gergelytothh/metromap/docs/images/pcb-3d.png

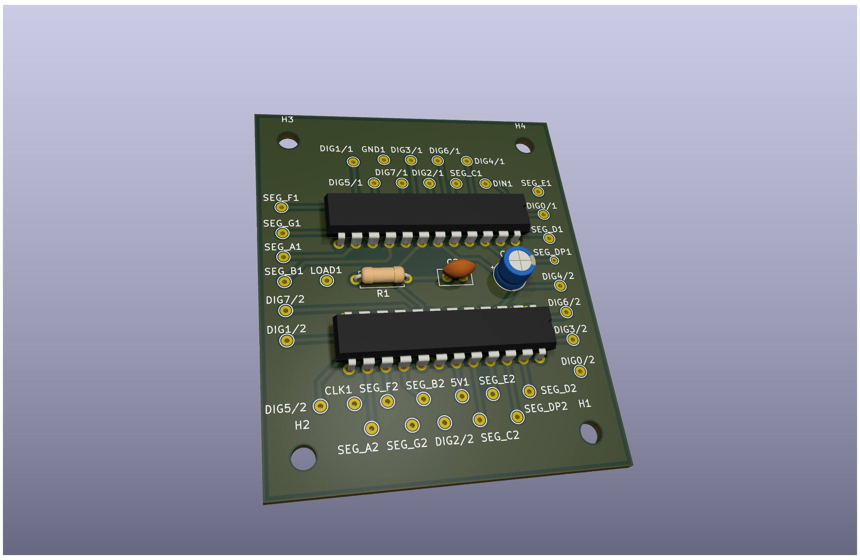
docs/images/pcb-3d.png
