gergelytothh/metromap/hardware/Metromap schematic.pdf

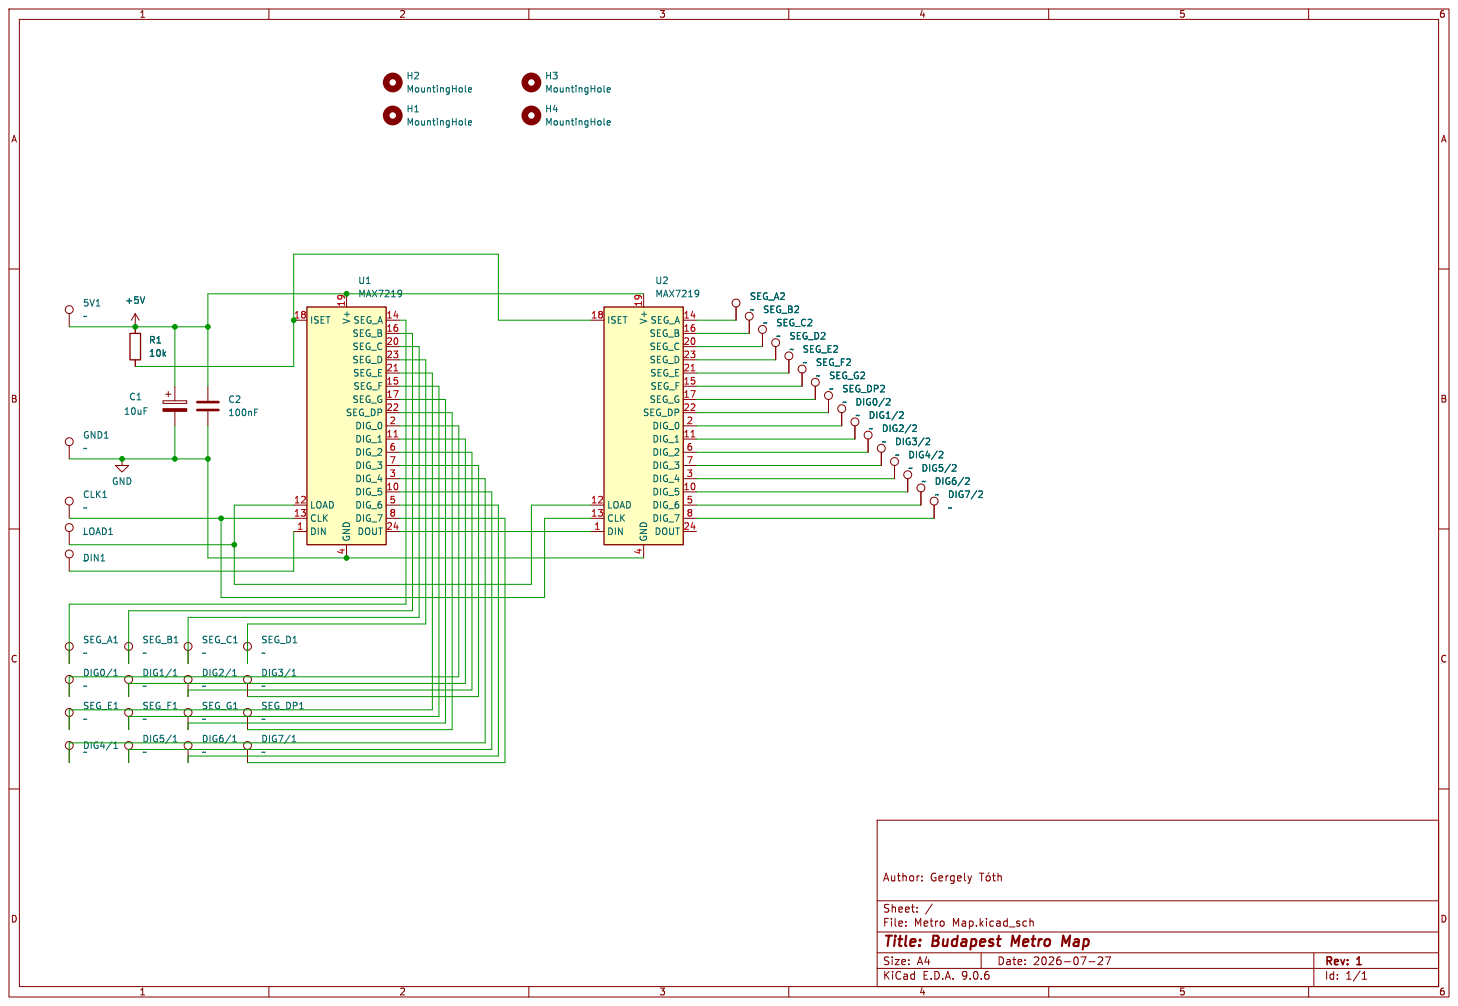
[picture p6: page 1]

Id: 1/1 Title: Budapest Metro Map
