gergelytothh/metromap/hardware/kicad/Metro Map.kicad_pcb

## KiCad design hardware/kicad/Metro Map.kicad_pcb (2026-10-12)

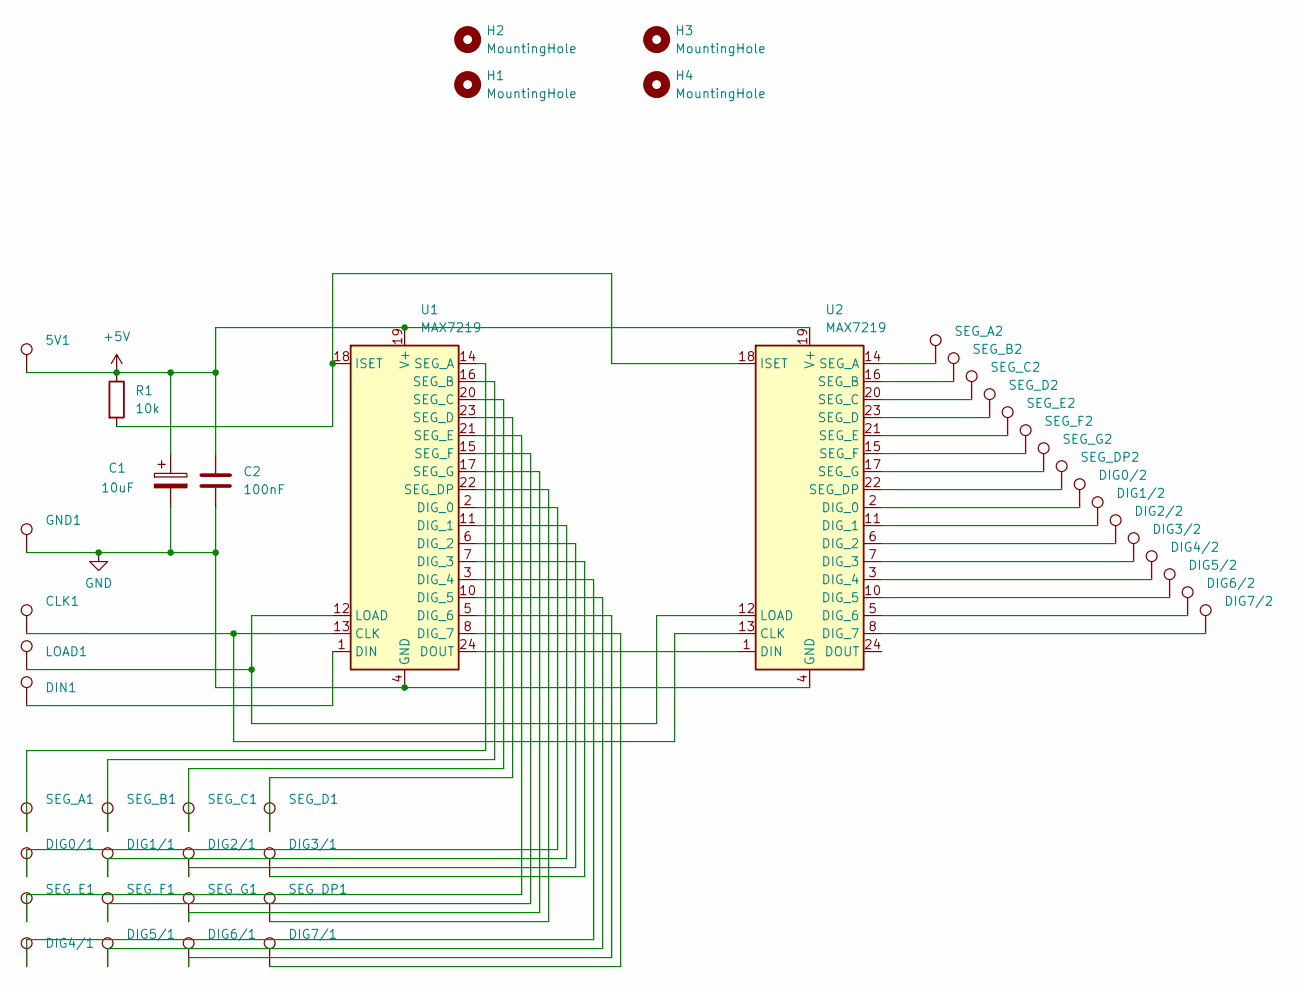
[picture p7: schematic Metro Map.kicad_sch, Budapest Metro Map]

Parts:
5V1: TestPoint_THTPad_D1.5mm_Drill0.7mm
C1: 10uF; CP_Radial_D5.0mm_P2.00mm
C2: 100nF; C_Disc_D5.0mm_W2.5mm_P2.50mm
CLK1: TestPoint_THTPad_D1.5mm_Drill0.7mm
DIG0/1, DIG0/2, DIG1/1, DIG1/2, DIG2/1, DIG2/2, DIG3/1, DIG3/2, DIG4/1, DIG4/2, DIG5/1, DIG5/2, DIG6/1, DIG6/2, DIG7/1, DIG7/2: TestPoint_THTPad_D1.5mm_Drill0.7mm
DIN1: TestPoint_THTPad_D1.5mm_Drill0.7mm
GND1: TestPoint_THTPad_D1.5mm_Drill0.7mm
H1, H2, H3, H4: MountingHole; MountingHole_3.2mm_M3
LOAD1: TestPoint_THTPad_D1.5mm_Drill0.7mm
R1: 10k; R_Axial_DIN0207_L6.3mm_D2.5mm_P7.62mm_Horizontal
SEG_A1, SEG_A2: TestPoint_THTPad_D1.5mm_Drill0.7mm
SEG_B1, SEG_B2: TestPoint_THTPad_D1.5mm_Drill0.7mm
SEG_C1, SEG_C2: TestPoint_THTPad_D1.5mm_Drill0.7mm
SEG_D1, SEG_D2: TestPoint_THTPad_D1.5mm_Drill0.7mm
SEG_DP1, SEG_DP2: TestPoint_THTPad_D1.5mm_Drill0.7mm
SEG_E1, SEG_E2: TestPoint_THTPad_D1.5mm_Drill0.7mm
SEG_F1, SEG_F2: TestPoint_THTPad_D1.5mm_Drill0.7mm
SEG_G1, SEG_G2: TestPoint_THTPad_D1.5mm_Drill0.7mm
U1, U2: MAX7219; DIP-24_W7.62mm

Connections:
+5V: 5V1.1, C1.1, C2.1, R1.1, U1.19 (V+), U2.19 (V+)
GND: C1.2, C2.2, GND1.1, U1.4 (GND), U1.9 (GND), U2.4 (GND), U2.9 (GND)
unnamed: CLK1.1, U1.13 (CLK), U2.13 (CLK)
unnamed: DIG0/1.1, U1.2 (DIG_0)
unnamed: DIG1/1.1, U1.11 (DIG_1)
unnamed: DIG2/1.1, U1.6 (DIG_2)
unnamed: DIG3/1.1, U1.7 (DIG_3)
unnamed: DIG4/1.1, U1.3 (DIG_4)
unnamed: DIG5/1.1, U1.10 (DIG_5)
unnamed: DIG6/1.1, U1.5 (DIG_6)
unnamed: DIG7/1.1, U1.8 (DIG_7)
unnamed: DIN1.1, U1.1 (DIN)
unnamed: U1.24 (DOUT), U2.1 (DIN)
unnamed: R1.2, U1.18 (ISET), U2.18 (ISET)
unnamed: LOAD1.1, U1.12 (LOAD), U2.12 (LOAD)
unnamed: SEG_A1.1, U1.14 (SEG_A)
unnamed: SEG_B1.1, U1.16 (SEG_B)
unnamed: SEG_C1.1, U1.20 (SEG_C)
unnamed: SEG_D1.1, U1.23 (SEG_D)
unnamed: SEG_DP1.1, U1.22 (SEG_DP)
unnamed: SEG_E1.1, U1.21 (SEG_E)
unnamed: SEG_F1.1, U1.15 (SEG_F)
unnamed: SEG_G1.1, U1.17 (SEG_G)
unnamed: DIG0/2.1, U2.2 (DIG_0)
unnamed: DIG1/2.1, U2.11 (DIG_1)
unnamed: DIG2/2.1, U2.6 (DIG_2)
unnamed: DIG3/2.1, U2.7 (DIG_3)
unnamed: DIG4/2.1, U2.3 (DIG_4)
unnamed: DIG5/2.1, U2.10 (DIG_5)
unnamed: DIG6/2.1, U2.5 (DIG_6)
unnamed: DIG7/2.1, U2.8 (DIG_7)
unnamed: SEG_A2.1, U2.14 (SEG_A)
unnamed: SEG_B2.1, U2.16 (SEG_B)
unnamed: SEG_C2.1, U2.20 (SEG_C)
unnamed: SEG_D2.1, U2.23 (SEG_D)
unnamed: SEG_DP2.1, U2.22 (SEG_DP)
unnamed: SEG_E2.1, U2.21 (SEG_E)
unnamed: SEG_F2.1, U2.15 (SEG_F)
unnamed: SEG_G2.1, U2.17 (SEG_G)

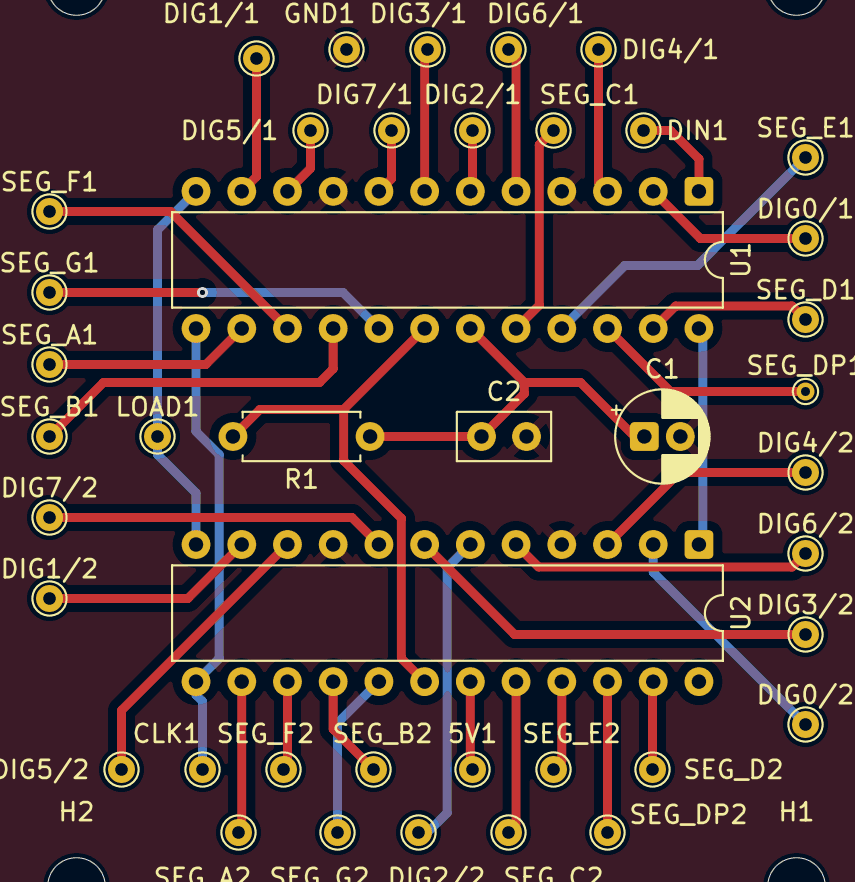
[picture p8: board Metro Map.kicad_pcb from above]

Board: 2 copper layers, 46 parts (0 on the bottom side), 39 nets.
