gergelytothh/metromap/(commit log)

2026-10-12 Repo structure and station-to-LED mapping
    [led-mapping.csv]
2026-10-12 Ignore KiCAD lock files
2026-10-12 Add KiCAD schematic and PCB
    [Metro Map.kicad_pcb, Metro Map.kicad_sch]
2026-10-12 Add schematic PDF and 3D PCB render
2026-10-12 Add LED id (1-96) to station map
2026-10-12 Add LED helpers, walk test and four-train mode
2026-10-26 Correct solder joint count in README
    Updated the total number of solder joints to ~280.
